UncleRus/WAMP/selector/selector.pdf

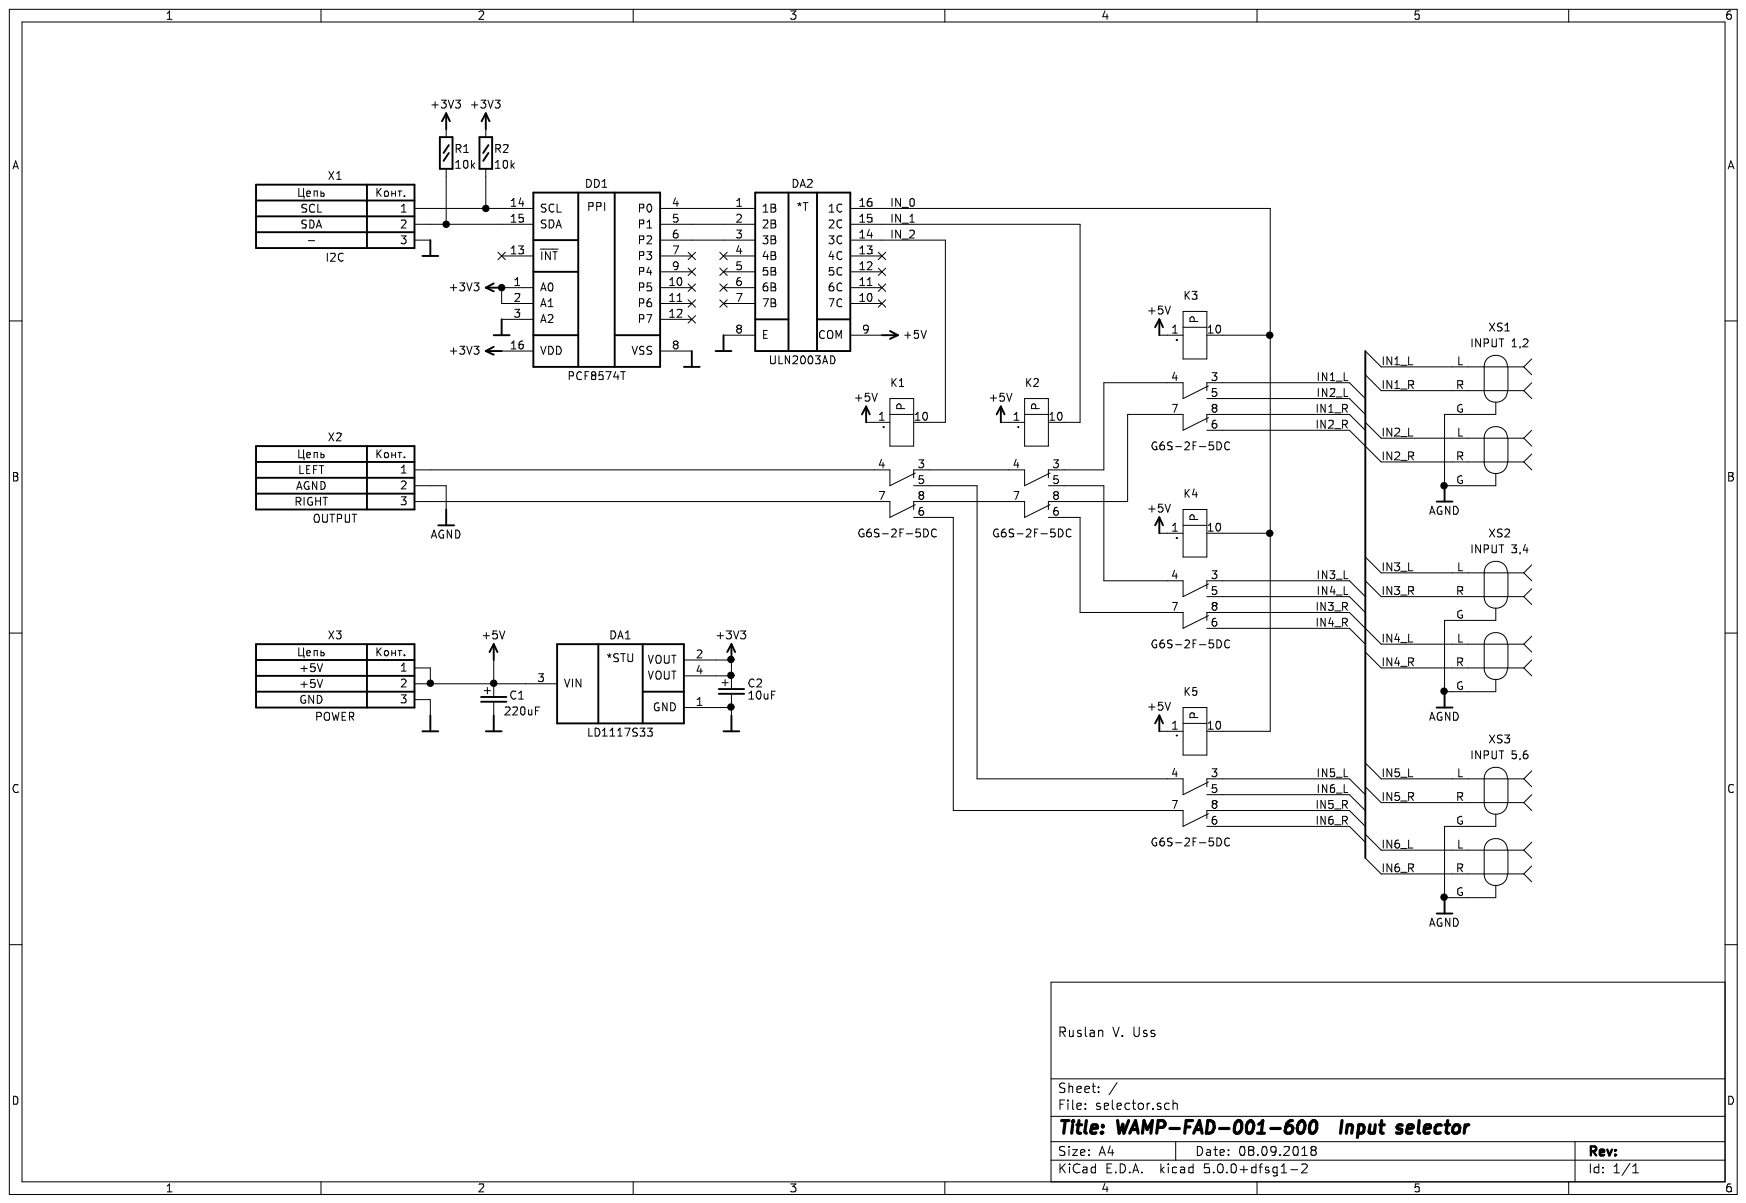
[picture p1: page 1]
