UncleRus/WAMP/mainboard/mainboard.kicad_pcb

## KiCad design mainboard/mainboard.kicad_pcb (2018-11-02)

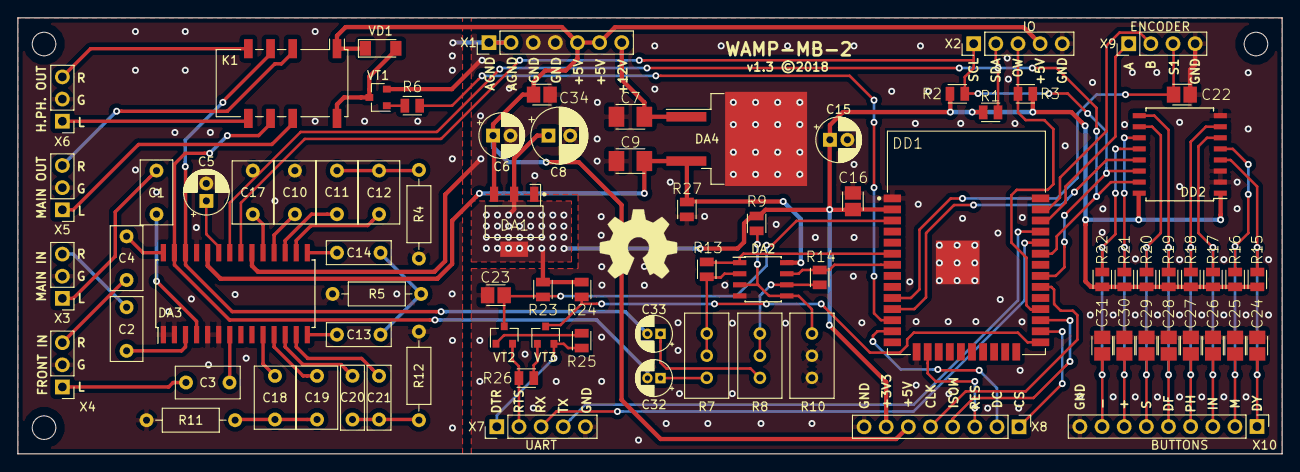
[picture p2: board mainboard.kicad_pcb from above]

Board: 2 copper layers, 145.0 x 50.0 mm, 82 parts (0 on the bottom side), 73 nets.

Parts:
C1, C2, C3, C4: 470n; C_Rect_L7.2mm_W3.5mm_P5.00mm_FKS2_FKP2_MKS2_MKP2
C5, C6: 10uF; CP_Radial_D5.0mm_P2.00mm
C7: 330n; CAPC3216X180N
C8: 100uF; CP_Radial_D6.3mm_P2.50mm
C9: 100n; CAPC3216X180N
C10, C17: 5n6; C_Rect_L7.0mm_W4.5mm_P5.00mm
C11, C18: 18n; C_Rect_L7.0mm_W4.5mm_P5.00mm
C12, C19: 22n; C_Rect_L7.0mm_W4.5mm_P5.00mm
C13, C14, C20, C21: 100n; C_Rect_L7.2mm_W2.5mm_P5.00mm_FKS2_FKP2_MKS2_MKP2
C15: 22uF; CP_Radial_D5.0mm_P2.00mm
C16, C22, C23, C24, C25, C26, C27, C28, C29, C30, C31, C34: 100n; CAPC2013X140N
C32, C33: 1uF; CP_Radial_D4.0mm_P1.50mm
DA1: LD1117S33; SOT230P700X180-4N
DA2: LM358DT; SOIC-8_3.9x4.9mm_P1.27mm
DA3: TDA7439DS; SOIC-28W_7.5x17.9mm_P1.27mm
DA4: L7809P; TO-263-2
DD1: ESP32-WROOM-32; ESPRESSIF_ESP32-WROOM-32
DD2: PCF8574T; SOIC-16W_7.5x10.3mm_P1.27mm
K1: G6S-2F-5DC; Relay_DPDT_Omron_G6S-2F
R1, R2, R24: 4k7; RESC2013X65N
R3, R6, R15, R16, R17, R18, R19, R20, R21, R22, R23, R25, R26: 10k; RESC2013X65N
R4, R11: 2k7; R_Axial_DIN0207_L6.3mm_D2.5mm_P10.16mm_Horizontal
R5, R12: 5k6; R_Axial_DIN0207_L6.3mm_D2.5mm_P10.16mm_Horizontal
R7, R8: 200k; Potentiometer_Bourns_3296W_Vertical
R9: 100k; RESC2013X65N
R10: 50k; Potentiometer_Bourns_3296W_Vertical
R13, R14: 50k; RESC2013X65N
R27: 3k3; RESC2013X65N
VD1: 1N4148; D_MiniMELF
VT1, VT2, VT3: MMBT3904; SOT-23
X1: POWER; PinHeader_1x07_P2.54mm_Vertical
X2: IO; PinHeader_1x05_P2.54mm_Vertical
X3: INPUT; PinHeader_1x03_P2.54mm_Vertical
X4: FRONT INPUT; PinHeader_1x03_P2.54mm_Vertical
X5: MAIN OUTPUT; PinHeader_1x03_P2.54mm_Vertical
X6: PHONES OUTPUT; PinHeader_1x03_P2.54mm_Vertical
X7: UART; PinHeader_1x05_P2.54mm_Vertical
X8: DISPLAY; PinHeader_1x08_P2.54mm_Vertical
X9: ENCODER; PinHeader_1x04_P2.54mm_Vertical
X10: BUTTONS; PinHeader_1x09_P2.54mm_Vertical

Connections:
+3V3: C8.1, C15.1, C16.1, DA1.2, DA1.4, DD1.2, DD2.1, DD2.16, R1.1, R2.1, R3.1, R9.1, R15.1, R16.1, R17.1, R18.1, R19.1, R20.1, R21.1, R22.1, R23.1, R24.1, X8.7
+5V: C6.1, C34.1, DA1.3, K1.1, VD1.1, X1.5, X1.6, X2.4, X8.6
+9V: C9.1, DA2.8, DA3.24, DA4.3, R27.1
/12V: C7.1, DA4.1, X1.7
/ADC6: DA2.1, DD1.6, R13.2
/ADC7: DA2.7, DD1.7, R14.1
/BINT: DD1.11, DD2.13
/BIN_L: C13.2, DA3.14
/BIN_R: C20.2, DA3.12
/BOUT_L: C14.2, DA3.15
/BOUT_R: C21.2, DA3.13
/B_DEFEAT: C28.1, DD2.9, R19.2, X10.5
/B_DISPLAY: C24.1, DD2.4, R15.2, X10.1
/B_INPUT: C26.1, DD2.6, R17.2, X10.3
/B_MINUS: C31.1, DD2.12, R22.2, X10.8
/B_MUTE: C25.1, DD2.5, R16.2, X10.2
/B_PHONES: C27.1, DD2.7, R18.2, X10.4
/B_PLUS: C30.1, DD2.11, R21.2, X10.7
/B_SETTINGS: C29.1, DD2.10, R20.2, X10.6
/CS0: DD1.26, X8.1
/DC: DD1.13, X8.2
/EN: C23.1, DD1.3, R23.2, VT2.3
/IO0: DD1.25, R24.2, VT3.3
/LOUT: C32.2, DA3.27, K1.7
/MIN_L: C11.2, DA3.17
/MIN_R: C18.2, DA3.10
/MOSI: DD1.27, X8.4
/MOUT_L: C12.2, DA3.16
/MOUT_R: C19.2, DA3.11
/ONEWIRE: DD1.28, R3.2, X2.3
/PH_SW: DD1.12, R6.2
/RES: DD1.16, X8.3
/RE_A: DD1.36, X9.1
/RE_B: DD1.37, X9.2
/RE_BTN: C22.1, DD1.10, X9.3
/ROUT: C33.2, DA3.26, K1.4
/RXD: DD1.34, X7.3
/SCL: DA3.21, DD1.31, DD2.14, R2.2, X2.1
/SCLK: DD1.30, X8.5
/SDA: DA3.22, DD1.33, DD2.15, R1.2, X2.2
/TREB_L: C10.2, DA3.18
/TREB_R: C17.2, DA3.19
/TXD: DD1.35, X7.4
AGND: C5.2, C10.1, C17.1, DA3.1, DA3.2, DA3.5, DA3.6, DA3.25, R4.1, R5.1, R11.2, R12.2, X1.1, X1.2, X3.2, X4.2, X5.2, X6.2
GND: C6.2, C7.2, C8.2, C9.2, C15.2, C16.2, C22.2, C23.2, C24.2, C25.2, C26.2, C27.2, C28.2, C29.2, C30.2, C31.2, C34.2, DA1.1, DA2.4, DA3.20, DA4.2, DD1.1, DD1.15, DD1.38, DD1.39, DD2.2, DD2.3, DD2.8, R10.2, R10.3, R27.2, VT1.2, X1.3, X1.4, X2.5, X7.5, X8.8, X9.4, X10.9
unnamed: C1.1, X3.1
unnamed: C1.2, DA3.4
unnamed: C2.1, X3.3
unnamed: C2.2, DA3.3
unnamed: C3.1, X4.1
unnamed: C3.2, DA3.7
unnamed: C4.1, X4.3
unnamed: C4.2, DA3.28
unnamed: C5.1, DA3.23
unnamed: C11.1, C12.1, R4.2
unnamed: C13.1, C14.1, R5.2
unnamed: C18.1, C19.1, R11.1
unnamed: C20.1, C21.1, R12.1
unnamed: C32.1, R7.1
unnamed: C33.1, R8.1
unnamed: DA2.2, R7.2, R7.3, R13.1
unnamed: DA2.3, DA2.5, R9.2, R10.1
unnamed: DA2.6, R8.2, R8.3, R14.2
unnamed: K1.3, X5.3
unnamed: K1.5, X6.3
unnamed: K1.6, X6.1
unnamed: K1.8, X5.1
unnamed: K1.10, VD1.2, VT1.3
unnamed: R6.1, VT1.1
unnamed: R25.1, VT2.1
unnamed: R25.2, VT3.2, X7.1
unnamed: R26.1, VT3.1
unnamed: R26.2, VT2.2, X7.2
