UncleRus/WAMP/headphone_amp/headphone_amp.kicad_pcb

## KiCad design headphone_amp/headphone_amp.kicad_pcb (2018-10-02)

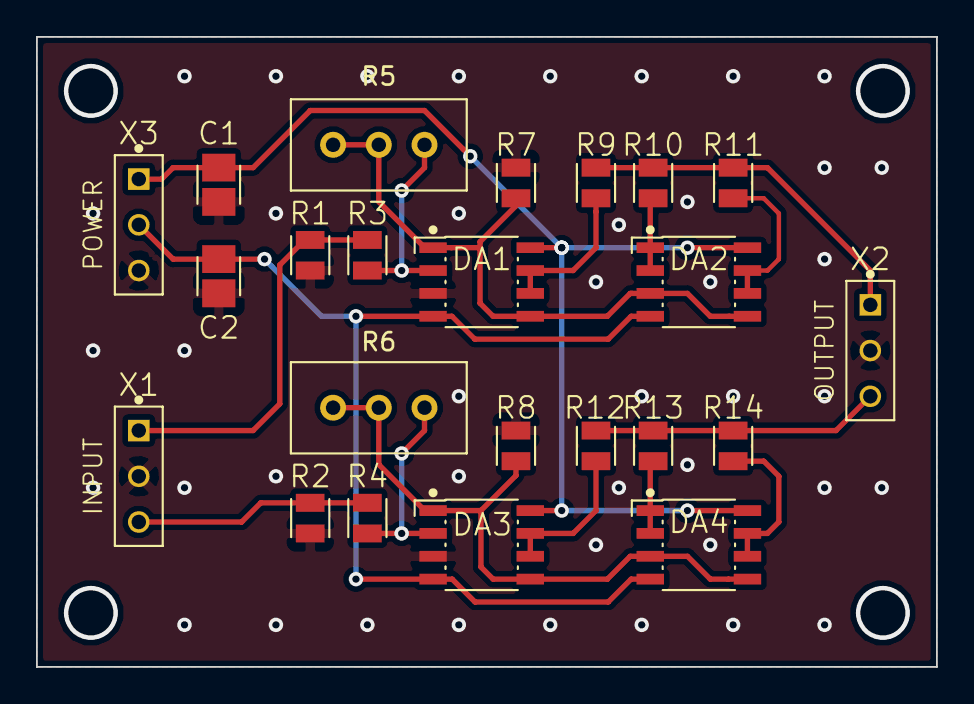
[picture p3: board headphone_amp.kicad_pcb from above]

Board: 2 copper layers, 50.0 x 35.0 mm, 23 parts (0 on the bottom side), 17 nets.

Parts:
C1, C2: 100n; CAPC2013X140N
DA1, DA2, DA3, DA4: NE5532AD; SOIC127P600X175-8N
R1, R2: 100k; RESC2013X65N
R3, R4, R7, R8: 10k; RESC2013X65N
R5, R6: 100k; Potentiometer_Bourns_3296W_Vertical
R9, R10, R11, R12, R13, R14: 300; RESC2013X65N
X1: INPUT; CON_CONN_BL_03X01
X2: OUTPUT; CON_CONN_BL_03X01
X3: POWER; CON_CONN_BL_03X01

Connections:
+15V: C1.1, DA1.8, DA2.8, DA3.8, DA4.8, X3.1
-15V: C2.1, DA1.4, DA2.4, DA3.4, DA4.4, X3.2
AGND: C1.2, C2.2, DA1.3, DA3.3, R1.1, R2.1, R7.1, R8.1, X1.2, X2.2, X3.3
unnamed: DA1.1, DA1.5, DA2.3, DA2.5, R5.2, R5.3, R7.2
unnamed: DA1.2, R3.2, R5.1
unnamed: DA1.6, DA1.7, R9.1
unnamed: DA2.1, DA2.2, R10.1
unnamed: DA2.6, DA2.7, R11.1
unnamed: DA3.1, DA3.5, DA4.3, DA4.5, R6.2, R6.3, R8.2
unnamed: DA3.2, R4.2, R6.1
unnamed: DA3.6, DA3.7, R12.1
unnamed: DA4.1, DA4.2, R13.1
unnamed: DA4.6, DA4.7, R14.1
unnamed: R1.2, R3.1, X1.1
unnamed: R2.2, R4.1, X1.3
unnamed: R9.2, R10.2, R11.2, X2.1
unnamed: R12.2, R13.2, R14.2, X2.3
