UncleRus/WAMP/selector/selector.kicad_pcb

## KiCad design selector/selector.kicad_pcb (2018-10-02)

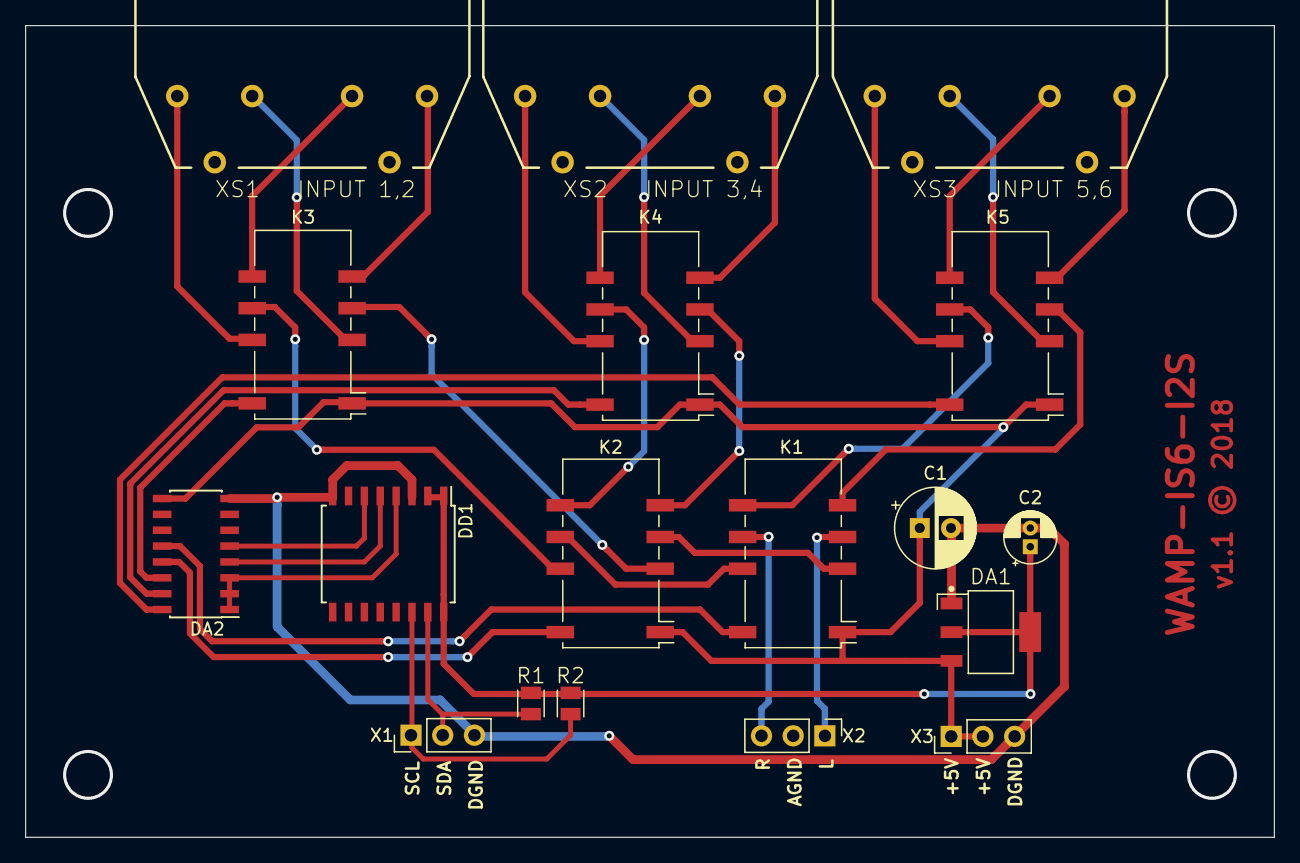
[picture p4: board selector.kicad_pcb from above]

Board: 2 copper layers, 100.0 x 65.0 mm, 18 parts (0 on the bottom side), 36 nets.

Parts:
C1: 220uF; CP_Radial_D6.3mm_P2.50mm
C2: 10uF; CP_Radial_D4.0mm_P1.50mm
DA1: LD1117S33; SOT230P700X180-4N
DA2: ULN2003AD; SOIC-16_3.9x9.9mm_P1.27mm
DD1: PCF8574T; SOIC-16W_7.5x10.3mm_P1.27mm
K1, K2, K3, K4, K5: G6S-2F-5DC; Relay_DPDT_Omron_G6S-2F
R1, R2: 10k; RESC2013X65N
X1: I2C; PinHeader_1x03_P2.54mm_Vertical
X2: OUTPUT; PinHeader_1x03_P2.54mm_Vertical
X3: POWER; PinHeader_1x03_P2.54mm_Vertical
XS1: INPUT 1,2; con-amphenol-RCA-4-117-01
XS2: INPUT 3,4; con-amphenol-RCA-4-117-01
XS3: INPUT 5,6; con-amphenol-RCA-4-117-01

Connections:
+3V3: C2.1, DA1.2, DA1.4, DD1.1, DD1.2, DD1.16, R1.1, R2.1
+5V: C1.1, DA1.3, DA2.9, K1.1, K2.1, K3.1, K4.1, K5.1, X3.1, X3.2
/IN1_L: K3.3, XS1.1
/IN1_R: K3.8, XS1.2
/IN2_L: K3.5, XS1.4
/IN2_R: K3.6, XS1.5
/IN3_L: K4.3, XS2.1
/IN3_R: K4.8, XS2.2
/IN4_L: K4.5, XS2.4
/IN4_R: K4.6, XS2.5
/IN5_L: K5.3, XS3.1
/IN5_R: K5.8, XS3.2
/IN6_L: K5.5, XS3.4
/IN6_R: K5.6, XS3.5
/IN_0A: DA2.16, K5.10
/IN_0B: DA2.15, K4.10
/IN_0C: DA2.14, K3.10
/IN_1: DA2.13, K2.10
/IN_2: DA2.12, K1.10
AGND: X2.2, XS1.3, XS1.6, XS2.3, XS2.6, XS3.3, XS3.6
GND: C1.2, C2.2, DA1.1, DA2.8, DD1.3, DD1.8, X1.3, X3.3
unnamed: DA2.1, DA2.2, DA2.3, DD1.4
unnamed: DA2.4, DD1.5
unnamed: DA2.5, DD1.6
unnamed: DD1.14, R2.2, X1.1
unnamed: DD1.15, R1.2, X1.2
unnamed: K1.3, K2.4
unnamed: K1.4, X2.1
unnamed: K1.5, K5.4
unnamed: K1.6, K5.7
unnamed: K1.7, X2.3
unnamed: K1.8, K2.7
unnamed: K2.3, K3.4
unnamed: K2.5, K4.4
unnamed: K2.6, K4.7
unnamed: K2.8, K3.7
