UncleRus/WAMP/power/power.kicad_pcb

## KiCad design power/power.kicad_pcb (2018-09-21)

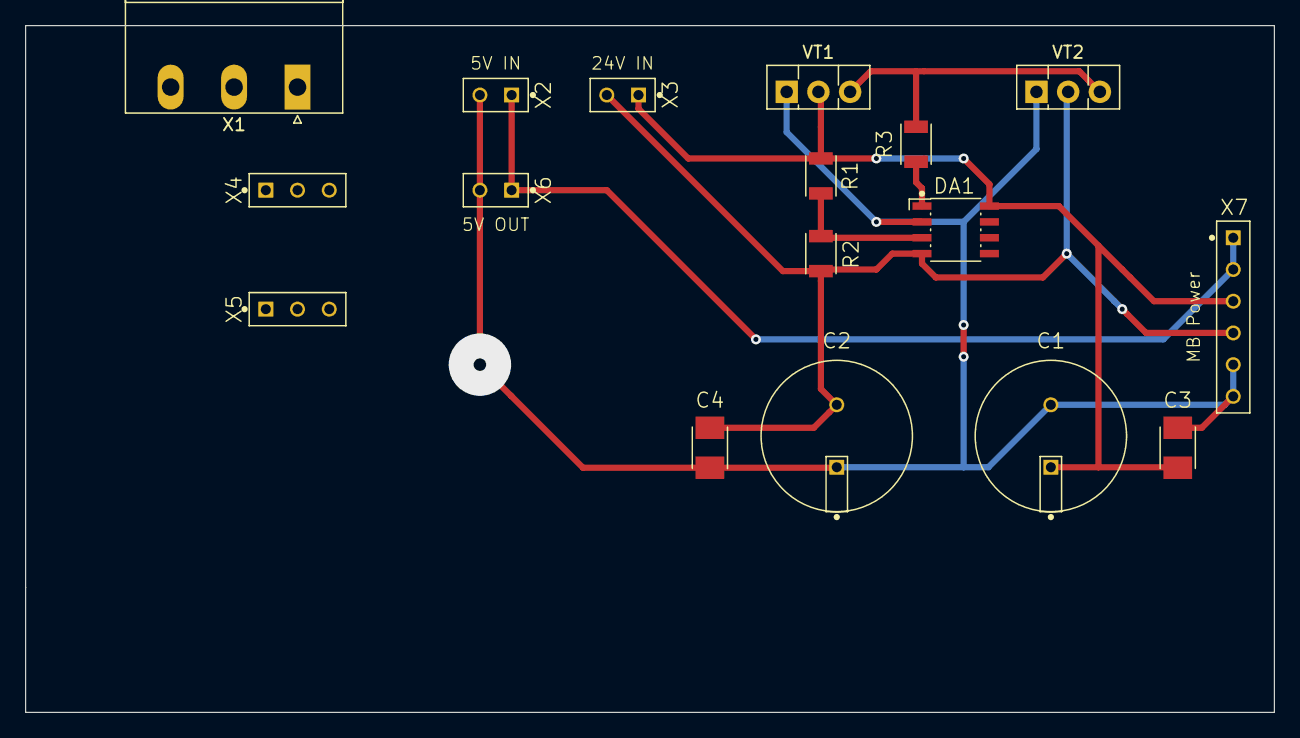
[picture p5: board power.kicad_pcb from above]

Board: 2 copper layers, 100.0 x 55.0 mm, 17 parts (0 on the bottom side), 9 nets.

Parts:
C1, C2: 2200uF; CAPPRD500W60D1200H2700N
C3, C4: 220n; CAPC3216X180N
DA1: LM393M; SOIC127P600X175-8N
R1, R2: 10k; RESC3115X65N
R3: 1k; RESC3115X65N
VT1: BD135; TO-126-3_Vertical
VT2: BD136; TO-126-3_Vertical
X1: PA IN; PhoenixContact_MSTBA_2,5_3-G-5,08_1x03_P5.08mm_Horizontal
X2: 5V IN; CON_CONN_BL_02X01
X3: 24V IN; CON_CONN_BL_02X01
X4: PA OUT1; CON_CONN_BL_03X01
X5: PA OU2; CON_CONN_BL_03X01
X6: 5V OUT; CON_CONN_BL_02X01
X7: MB Power; CON_CONN_BL_06X01

Connections:
/+5V: X2.1, X6.1, X7.1, X7.2
/+12V: C1.1, C3.1, DA1.8, R1.1, VT1.2, X3.1, X7.3
/+58V: X1.1, X4.1, X5.1
/-12V: C2.2, C4.2, DA1.4, R2.2, VT2.2, X3.2, X7.4
/-58V: X1.3, X4.3, X5.3
GND: C1.2, C2.1, C3.2, C4.1, DA1.2, VT1.1, VT2.1, X1.2, X2.2, X4.2, X5.2, X6.2, X7.5, X7.6
unnamed: DA1.1, R3.1
unnamed: DA1.3, R1.2, R2.1
unnamed: R3.2, VT1.3, VT2.3
