UncleRus/WAMP/firmware/main/common.h

#ifndef _COMMON_H_
#define _COMMON_H_

#define CHECK(x) do { esp_err_t __; if ((__ = x) != ESP_OK) return __; } while (0)
#define CHECK_ARG(VAL) do { if (!(VAL)) return ESP_ERR_INVALID_ARG; } while (0)
#define CHECK_LOGE(x, msg, ...) do { \
        esp_err_t __; \
        if ((__ = x) != ESP_OK) { \
            ESP_LOGE(TAG, msg, ## __VA_ARGS__); \
            return __; \
        } \
    } while (0)


#endif /* _COMMON_H_ */
