UncleRus/WAMP/(commit log)

2018-09-12 Initial upload
    [mainboard.kicad_pcb, mainboard.sch, selector.kicad_pcb, selector.sch]
2018-09-12 Schematics for input selector in PDF
2018-09-12 Fixed selector PCB, relays on different ULN2003 lines, mainboard pcb
    [mainboard.kicad_pcb, selector.kicad_pcb, selector.sch]
2018-09-15 Simpler mainboard
    [mainboard.kicad_pcb, mainboard.sch]
2018-09-15 mainboard pdf
    [mainboard-B.Cu.gbr, mainboard-B.Mask.gbr, mainboard-B.Paste.gbr, mainboard-B.SilkS.gbr, mainboard-Edge.Cuts.gbr, mainboard-F.Cu.gbr, mainboard-F.Mask.gbr, mainboard-F.Paste.gbr]
2018-09-15 gitignore updated
    [mainboard-B.Cu.gbr, mainboard-B.Mask.gbr, mainboard-B.Paste.gbr, mainboard-B.SilkS.gbr, mainboard-Edge.Cuts.gbr, mainboard-F.Cu.gbr, mainboard-F.Mask.gbr, mainboard-F.Paste.gbr]
2018-09-21 Film caps on MB, new powering scheme, opamp replaced
    [mainboard.kicad_pcb, mainboard.sch, power.kicad_pcb, power.sch, selector.kicad_pcb]
2018-09-21 Pad to mask clearance removed
    [mainboard.kicad_pcb]
2018-09-22 MB fixes
    [mainboard.kicad_pcb, mainboard.sch]
2018-09-22 Potentiometers to MB ADC module
    [mainboard.kicad_pcb, mainboard.sch]
2018-09-23 Added blocking caps to ADC input
    [mainboard.kicad_pcb, mainboard.sch]
2018-09-24 MB 7809 pinout fixed
    [mainboard.kicad_pcb, mainboard.sch]
2018-10-02 Headphone amp added, minor MB fixes
    [headphone_amp.kicad_pcb, headphone_amp.sch, mainboard.kicad_pcb, mainboard.sch, selector.kicad_pcb, selector.sch]
2018-11-02 Firmware started
    [mainboard.kicad_pcb]
