UncleRus/WAMP/(notices)

Notices in the files:
selector/selector.kicad_pcb:
v1.1 © 2018
mainboard/mainboard.kicad_pcb:
v1.3 ©2018
